UoB-Interactive-Devices/ID26-TeamF-JJADE/prototypes/Prototype Design/Fusion_Link.md

Prototype Design: https://a360.co/4aRiNHr
