UoB-Interactive-Devices/ID26-TeamF-JJADE/docs/Interactive Devices writing.odt

Write a paragraph in your group:

What is your device?

Shroom: Seasoning mushroom, it’s a smart seasoning carousel.

It has refillable seasoning containers suspended upside down on a carousel and a stand in the middle. It has a fixed spot for a pot to dispense the seasonings into. It has a screen for control, voice activation, and an emergency stop button. It has feedback when conducting actions and a scale built in. It has an internal inventory of spices.

What does it do?

It simplifies the seasoning process by allowing user to press buttons or voice control to put in seasoning to your food.
Press button, then spins around to your chosen spice.
Then the lid gets pushed open (somehow?) and dispenses the spice to the desired amount, with a scale under the pot to detect that.
Have a screen that suggests recipes and tells you what spice to use.
Track your spice usage to create a “Spice Wrap” as a summary of spice usage at the end of the year.
Notify users when spices are running low. We want users to be happy!

What is the outcome?

The outcome is to help people get familiar with cooking and the use of spice, and help people that have disabilities cooking. It helps saving time and turns cooking to be an enjoyable learning experience.

Creates a community of people using the machine.

How do users interact with it?

It is activated by a specific word (?) or by tapping the screen. It has voice activation or screen controls.
There are specific noises and words sounded to ensure that the user understands what is happening. E.g. A noise to show that the spice has been dispensed
There will be confirmation messages required (can be turned off in settings) to ensure the device has heard correctly.
There should be bowl detection to ensure there is a container beneeth
Emergency stop for whenever the device gets out of control e.g. item caught in the carousel, starting to dispense the wrong spice
Users will have to manually refill spice pots, and potentially set up the machine by telling what is in each area, so enable customisation
Connection with other devices is enabled, and allows for interaction between friend recommendations and recently used etc
