UoB-Interactive-Devices/ID26-TeamF-JJADE/docs/consentform_InteractionDesignUnit_2023 - Copy.docx

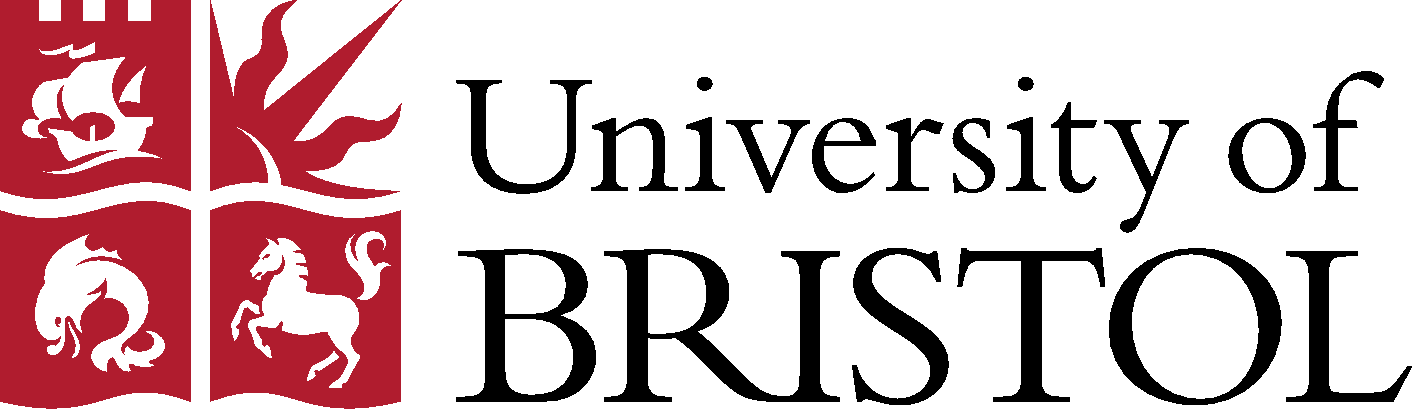
[picture p3: figure]
logo-ltr

Department of Computer Science Student names: James Bradley, Elsa Wakfi, Jamie Lo, Arsalan Ghogari and Daniel Bowen Supervisor names: Dr Anne Roudaut e-mail:

# CONSENT FORM

# University of Bristol – Interaction Design Unit Research

# [PROVIDE A SHORT VERSION OF YOUR INFORMATION SHEET. EXAMPLE BELOW. USE “WE” INSTEAD OF “THEY”]

Thank you for your interest in this study. We would like to invite you to take part in this research project. Before you decide whether or not to participate, we have provided further information on this study to inform you about it. We are undergraduate students at the University of Bristol within the Department of Computer Science studying the unit Interactive Devices COMS30054. We are conducting this study focusing on how users find the process of cooking, and how this can be improved and streamlined with the use of certain kitchen aids. We are interested in how people use this technology in their homes, their everyday life and the lives of others who may come into your home. You may talk to others about the study, and we welcome participation from more than one person in your household. You may ask us questions at any time, if anything about the study is unclear.

What is the purpose of the study?

The purpose of this study is to understand how cooking devices are used in the home, allowing users the ability to go about their daily lives. We understand that cooking for other people in the home can also be supported by devices. However, we wish to gain further knowledge about how people using technology at home can understand and use this equipment by themselves and with the other people they live with.

Why have I been invited to participate?

If you are reading this document, that means that you have shown an interest in taking part in this study and that you meet the eligibility criteria for taking part, which are:

- That you must be over the age of 18 years old
- You can provide consent
- You can read and converse in English

Do I have to take part?

Participation in this study is voluntary. If you decide you would like to go ahead with the study and take part, we will ask you to sign a consent form, and we will give you a copy of this information sheet to keep. Before you begin any interviews, we will describe the study again and check that you are happy to participate still. You are free to withdraw at any time, without giving a reason. If you are taking part in this study and are a member of the University of Bristol, your status at the university will not be impacted by taking part.

What will happen to me if I take part and what will I have to do?

If you decide to take part in the study, you will be given a questionnaire to fill in that should take no more than 10 minutes to complete and/or be asked to complete an optional short interview either in person or online.

Once the questionnaire and/or interview is complete, the data will be analysed by the research team and written up for our assessment, which we may decide to publish. Your name will be changed (pseudonymised) so that you are not identified as a participant. You will be given a “fake name” or participant number. If we decide to publish the work, you will then be given the opportunity to review your pseudonymised data in the publication and/or ask to remove any of your data from the study before it is published. The last date at which you will be able to request the researchers to remove your data from the study, before publication will be the 16th of March 2026.

What are the possible disadvantages and risks involved in taking part in the project?

Completing your interviews and questionnaire should not pose any physical risk to you... If you feel uncomfortable answering a question at any time, you can tell the researcher to move on, or stop the interview. We will ask to arrange all interviews with you at a time that is convenient for you, where you will be comfortable and free to answer the questions without time pressure. There will be no disadvantages to your academic status with the University of Bristol should you wish to withdraw from this study before its completion.

What are the possible benefits of taking part?

It is hoped that the outcomes of this study will provide benefits to the wider community in Bristol and elsewhere, by contributing knowledge as to how technology can improve quality of life while cooking. It is hoped that this study will contribute to our personal degrees as students and, potentially, to the future design of devices such as seasoning carousels.

Will my participation in this project be kept confidential?

After completion of the study, no further data will be collected from you or from the device for the study by the University of Bristol.

The anonymous data will be encrypted (as per University of Bristol Policy) and stored by the researchers (James Bradley, Elsa Wakfi, Jamie Lo, Arsalan Ghogari and Daniel Bowen) and the study leads, (Anne Roudaut, Peter Bennett and Kyle Keane) on a password-protected computer system only accessible by the researcher and PI and any other member of the research team who took part in the study.

If you have any questions about this aspect of the study, please do not hesitate to ask.

All personal information recorded on the consent form will be kept strictly confidential. All the interview responses to questions asked will have any information relating you to this study, removed. The data will be stored so that your name is not associated with it (it will be given a number instead of a name). All data will be handled confidentially, and your name will be removed/changed in the data. When we write up the interviews, we will not include any information that can be linked directly to you. The data collected from this study could be used in articles for publication in journals and conferences. Results from the research will be presented in accordance with rules for anonymity such that the results cannot be traced to individual participants.

Right to Withdraw: You are free to withdraw from the study at any time without penalty. Participants do not need to provide any reason for withdrawing. Withdrawal from the study will not affect your personal or academic status or your access to services at the university. If you withdraw, your data will be deleted from the study and destroyed. In addition, you are free to not answer specific items or questions within an interview.

Your continued participation should be as informed as your initial consent, so you should feel free to ask for clarification or new information throughout your participation. If you have further questions concerning matters related to this research, please contact the researchers: jjade-id2026@bristol.ac.uk or the Academic study lead on this project – Anne Roudaut (Anne.Roudaut@bristol.ac.uk).

Questions: If you have any questions concerning the study, please feel free to ask at any point; you are also free to contact the researchers provided above if you have questions at a later time. This study has been approved on ethical grounds by the University Of Bristol Faculty Of Engineering Ethics Board. Any questions regarding your rights as a participant may be addressed to that committee through the Faculty Ethics Officer (http://www.bris.ac.uk/red/support/governance/ethics/ethics.html). Please note that you are free to withdraw from participation at any time.

What will happen to the results of the research project?

The outcomes of this study will be written up to help support our undergraduate degrees and to contribute to knowledge in the field of computer science. We can also publish the findings from this study as a conference paper. The finalised, anonymised paper will be shared with you, when it is complete and if we decide to do so. You will then be able to review the paper and let us know if you want to change anything about how you are represented in this work, before it is sent for publication.

Who is organising and funding the research?

The University of Bristol (Department of Computer Science) are organising this research in association with James Bradley, Elsa Wakfi, Jamie Lo, Arsalan Ghogari and Daniel Bowen, and Anne Roudaut and the teaching staff on COMS30054.

Who has reviewed the study?

The study has been reviewed by the Principal Investigator (PI), Anne Roudaut (Anne.Roudaut@bristol.ac.uk). It has been approved by the University of Bristol, Faculty of Engineering Research Ethics committee.

Further information and contact details

Thank you for your interest and cooperation and if you would like more information about the research project or have any questions about this work, please feel free to contact the researchers at: jjade-id2026@bristol.ac.uk

If you have any concerns related to the study or about your participation in this study, please contact the Faculty of Engineering Research Ethics Committee, via the Research Governance Team, research-governance@bristol.ac.uk

## Please answer the following questions to the best of your knowledge

YES NO

Have you:

- been given information explaining about the study? □ □
- had an opportunity to ask questions and discuss this study? □ □
- received satisfactory answers to all questions you asked? □ □
- received enough information about the study for you to make a decision

about your participation? □ □

Do you understand:

That you are free to withdraw from the study and free to withdraw your data prior to final consent:

- at any time/ up until the point of anonymisation on 16th March 2026? □ □
- without having to give a reason for withdrawing? □ □
- that you have agreed to take part in a questionnaire and a possible optional interview? □ □
- That any optional interviews will be audio recorded? □ □
- that you will be required to fill in a questionnaire? □ □
- that you will need a working (reliable) internet/broadband connection in your home/place that participation takes place to take part in this trial? □ □

## I hereby fully and freely consent to my participation in this study

Participant’s signature: _____________________________________ Date: ________________

Name in BLOCK Letters: _____________________________________

If you have any concerns related to your participation in this study, please direct them to the Faculty of Engineering Research Ethics Committee, via the Research Governance Team; research-governance@bristol.ac.u
