UoB-Interactive-Devices/ID26-TeamF-JJADE/docs/images/IMG-20260310-WA0000.jpg

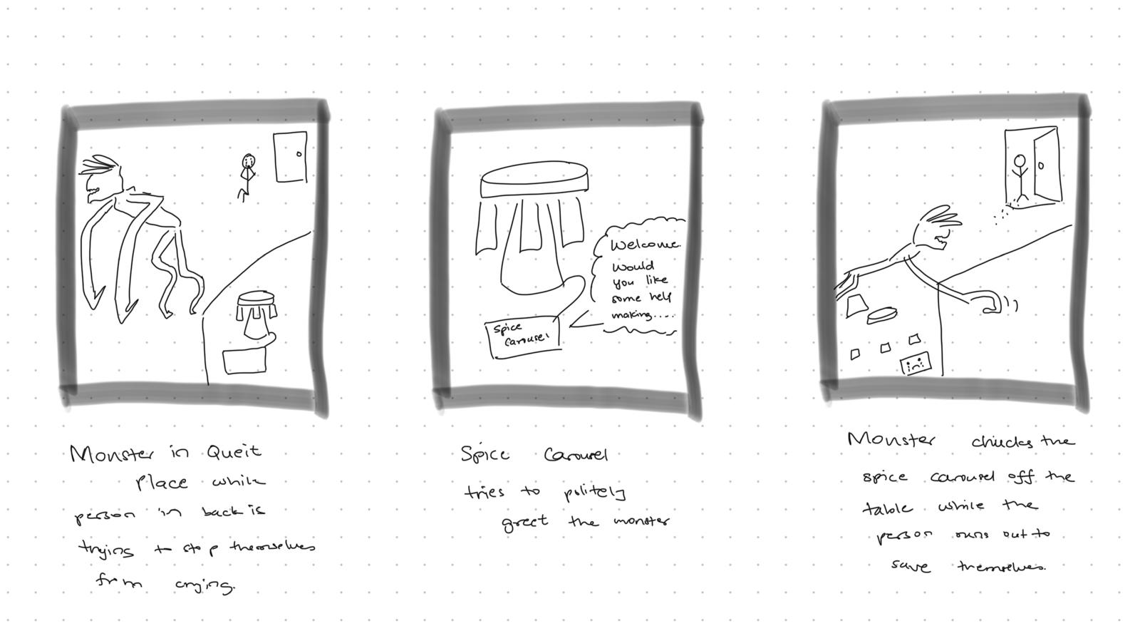
docs/images/IMG-20260310-WA0000.jpg
