UoB-Interactive-Devices/ID26-TeamF-JJADE/3D Print Models/Spice-Holder v1.obj

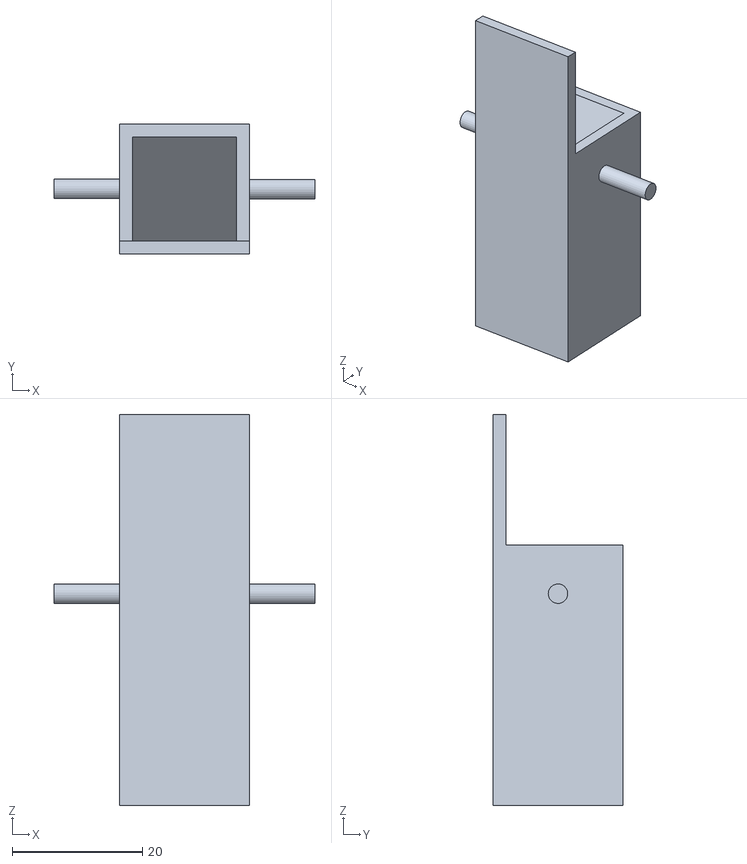
[picture p9: CAD file, 2026-03-28]
3D Print Models/Spice-Holder v1.obj
40.0 x 20.0 x 60.0
