UoB-Interactive-Devices/ID26-TeamF-JJADE/Laser Cut Models/CarouselStandModded.dxf

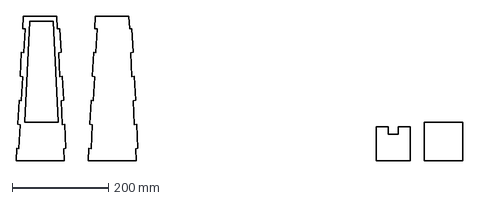
[picture p10: CAD file, 2026-03-28]
Laser Cut Models/CarouselStandModded.dxf
930.0 x 300.0 mm
