UoB-Interactive-Devices/ID26-TeamF-JJADE/3D Print Models/MediumServoContainer.stl

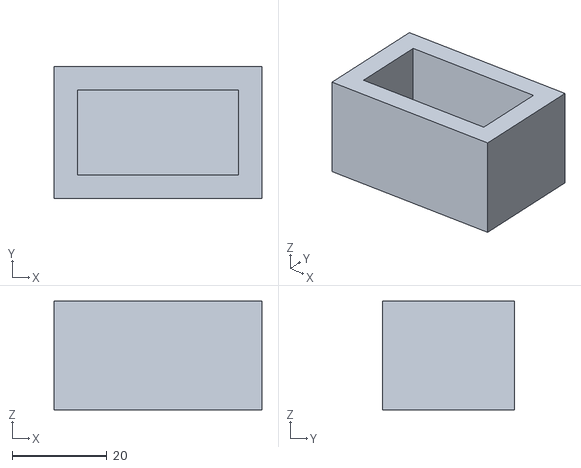
[picture p11: CAD file, 2026-03-28]
3D Print Models/MediumServoContainer.stl
44.0 x 28.0 x 23.0
