UoB-Interactive-Devices/ID26-TeamF-JJADE/Laser Cut Models/Big-Ring.dxf

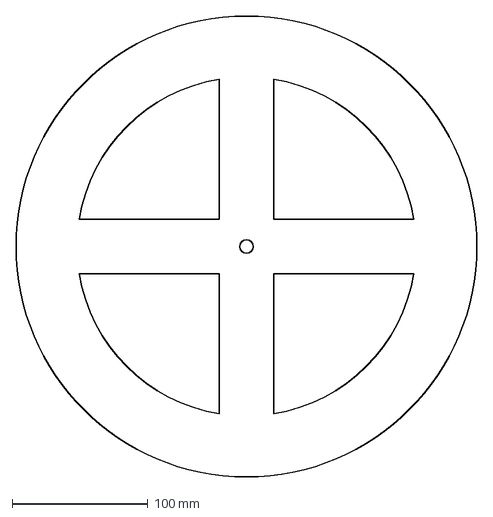
[picture p12: CAD file, 2026-03-28]
Laser Cut Models/Big-Ring.dxf
340.0 x 340.0 mm
