UoB-Interactive-Devices/ID26-TeamF-JJADE/3D Print Models/Sample Spice Carousel.obj

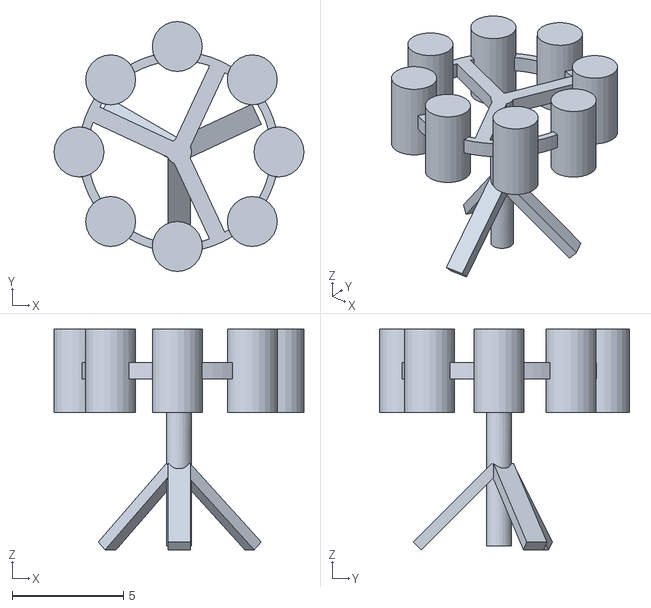
[picture p13: CAD file, 2026-02-23]
3D Print Models/Sample Spice Carousel.obj
11.2 x 11.2 x 9.93
