UoB-Interactive-Devices/ID26-TeamF-JJADE/Laser Cut Models/Spice-Holder-Holder.dxf

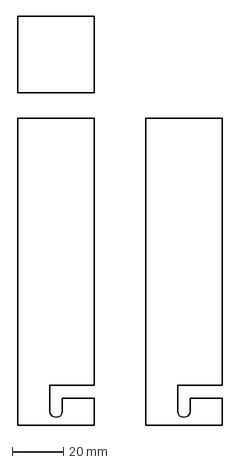
[picture p14: CAD file, 2026-03-28]
Laser Cut Models/Spice-Holder-Holder.dxf
80.0 x 160.0 mm
