UoB-Interactive-Devices/ID26-TeamF-JJADE/Laser Cut Models/CarouselStand.dxf

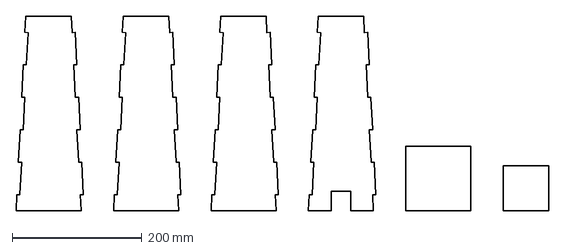
[picture p15: CAD file, 2026-03-28]
Laser Cut Models/CarouselStand.dxf
820.0 x 300.0 mm
