UoB-Interactive-Devices/ID26-TeamF-JJADE/(commit log)

2026-02-10 Rename WhatsApp Image 2026-02-09 at 11.40.33.jpeg to PlayDoh Prototype
2026-02-23 Added video of prototype
2026-02-23 Added 3D Print & Arduino Code
    Added code for moving a servo and 3D print docs for the initial prototype design
    [Sample Spice Carousel.obj]
2026-03-03 Arduino code to control spin via serial monitor
2026-03-03 Modified the code to make the servo spin
2026-03-28 Added all designs
    Added a folder each for laser cut and 3D print designs & added all current designs I have
    [Big-Ring.dxf, CarouselStand.dxf, CarouselStandModded.dxf, MediumServoContainer.stl, Sample Spice Carousel.obj, Spice-Holder v1.obj, Spice-Holder-Holder.dxf]
